Hardware7253/GP1247AI/Case/PCB_Assembly.step

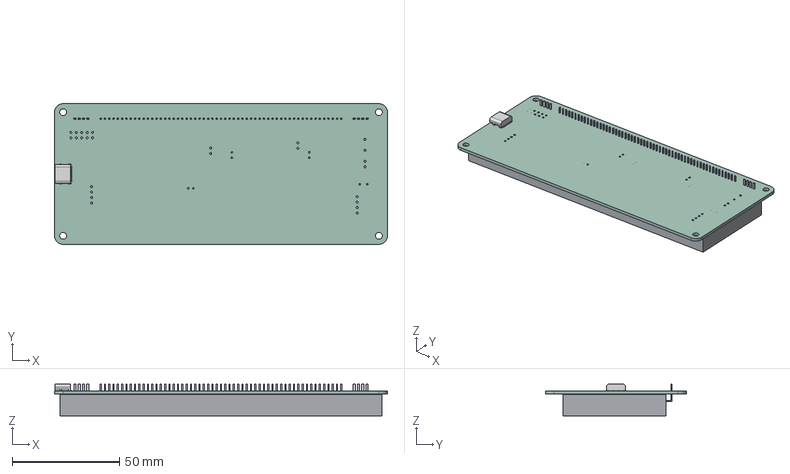
[picture p1: CAD file, 2026-02-13]
Case/PCB_Assembly.step
155.0 x 65.5 x 14.8 mm
HRO TYPE-C-31-M-12
Pin x 57
Filament Pin x 8
GP1247AI_PCB
