Hardware7253/GP1247AI/CAD/Case.step

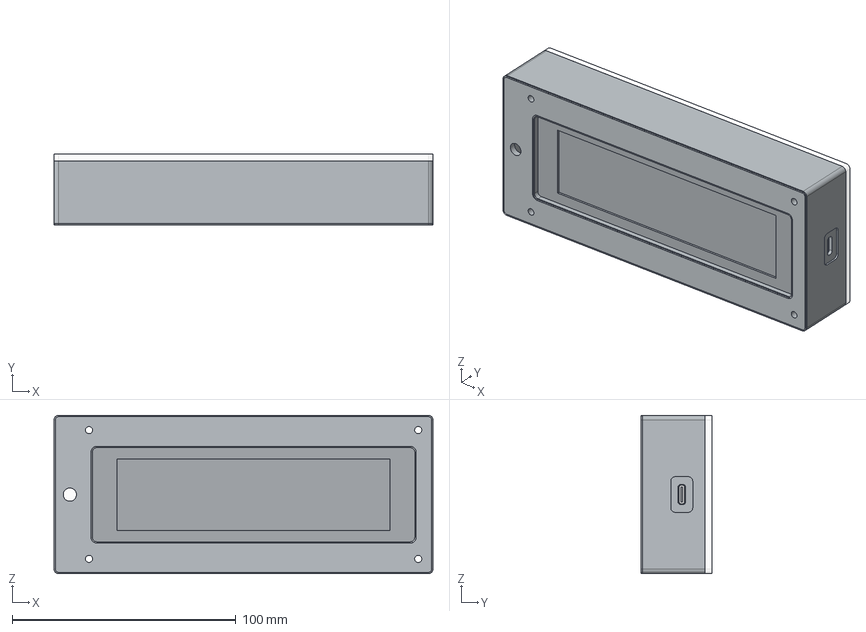
[picture p2: CAD file, 2026-02-13]
CAD/Case.step
169.3 x 31.5 x 70.7 mm
PCB South Spacer x 2
Case
GP1247AI_PCB
PCB North Spacer x 2
PCB Rear Spacer x 4
Display Spacer
HRO TYPE-C-31-M-12
Open Case Front Panel
Back Cover
Pin x 57
Filament Pin x 8
