Hardware7253/GP1247AI/PCB/3D/GP1247AI.step

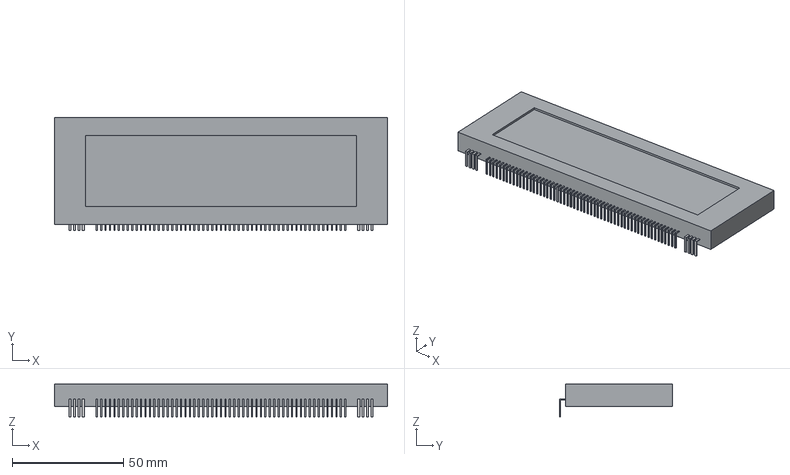
[picture p3: CAD file, 2026-02-13]
PCB/3D/GP1247AI.step
150.0 x 50.7 x 14.8 mm
Pin x 57
Filament Pin x 8
