Hardware7253/GP1247AI/PCB/3D/HRO  TYPE-C-31-M-12.step

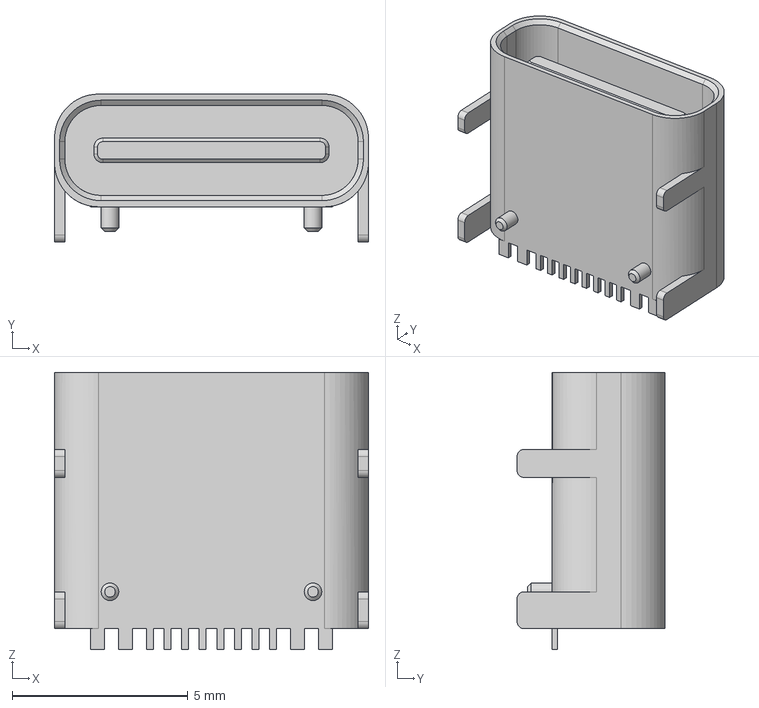
[picture p4: CAD file, 2026-02-09]
PCB/3D/HRO TYPE-C-31-M-12.step
8.94 x 4.21 x 7.90 mm
