Hardware7253/GP1247AI/PCB/3D/TC33X-1-103E.stp

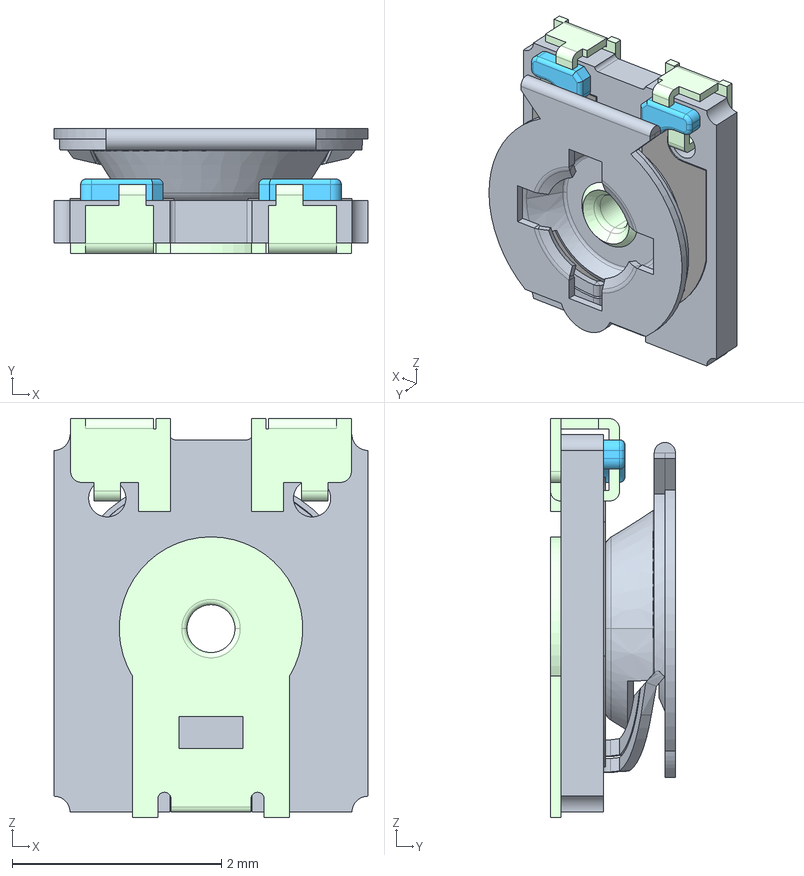
[picture p5: CAD file, 2025-11-30]
PCB/3D/TC33X-1-103E.stp
3.00 x 1.19 x 3.81 mm
TC33X_SUBSTRATE
TC33X_ELEMENT
TC33X-1_COLLECTOR
TC33X_CONTACT
TC33X_TERMINALS
TC33X_SOLDER
