Hardware7253/GP1247AI/PCB/3D/TestPoint_Keystone_5019_Minature.step

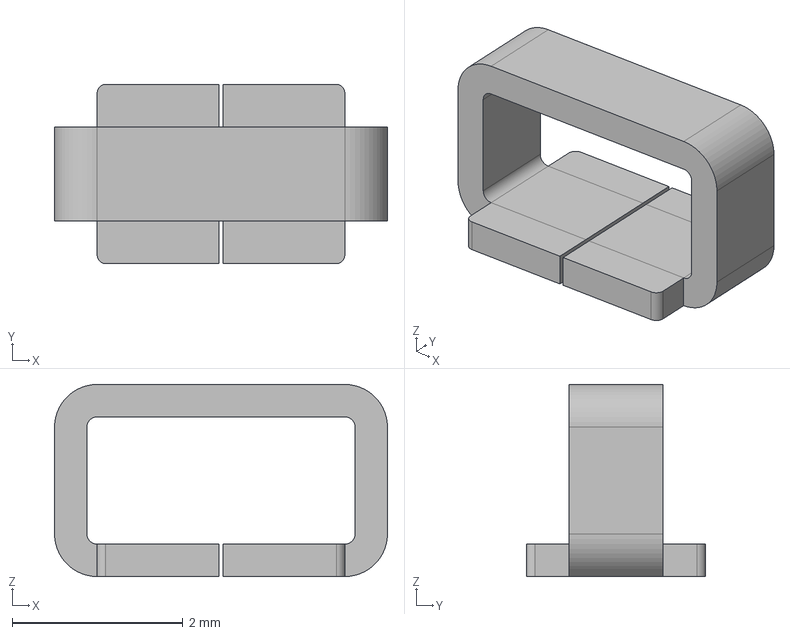
[picture p6: CAD file, 2025-11-30]
PCB/3D/TestPoint_Keystone_5019_Minature.step
3.90 x 2.10 x 2.25 mm
