Hardware7253/GP1247AI/PCB/3D/SCDS105R.step

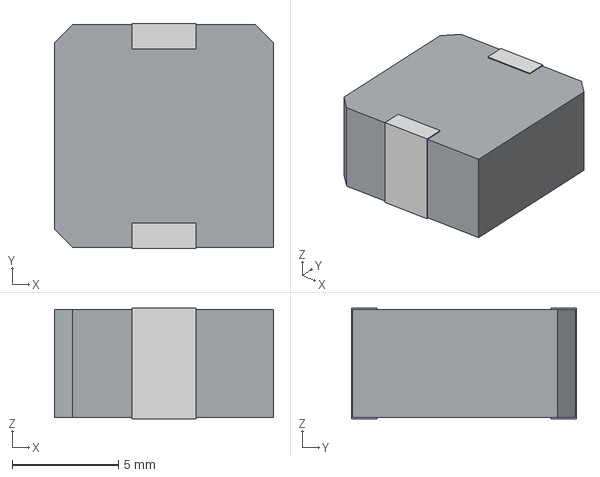
[picture p7: CAD file, 2025-11-30]
PCB/3D/SCDS105R.step
10.3 x 10.6 x 5.20 mm
