Hardware7253/GP1247AI/(list of files, cad)

Other CAD files:
Case/Case.step
