Hardware7253/GP1247AI/Case/manufacture/front_panel.pdf

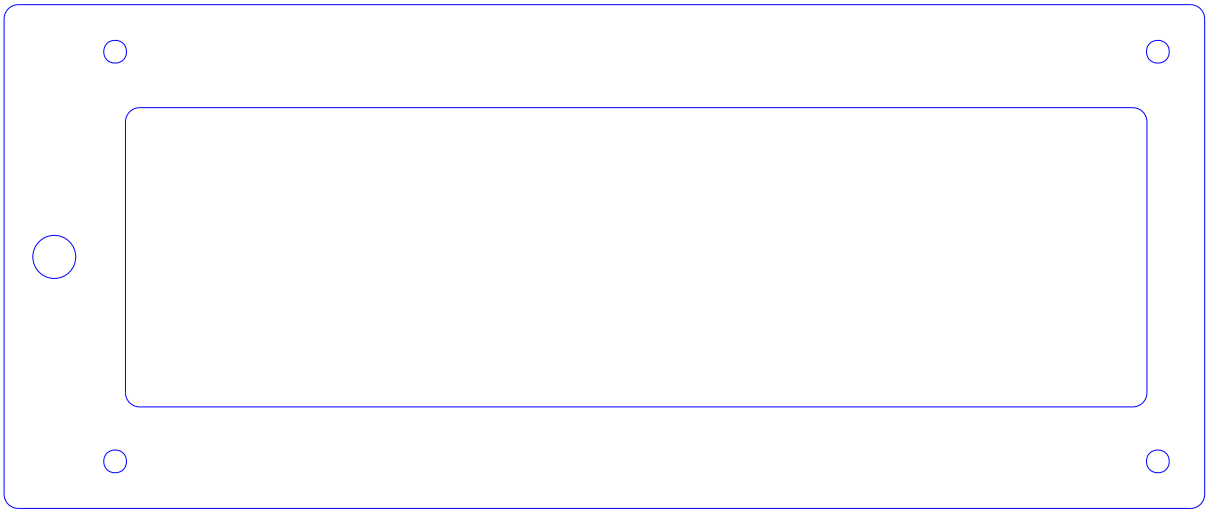
[picture p8: figure]
