Hardware7253/GP1247AI/Case/manufacture/back_panel.pdf

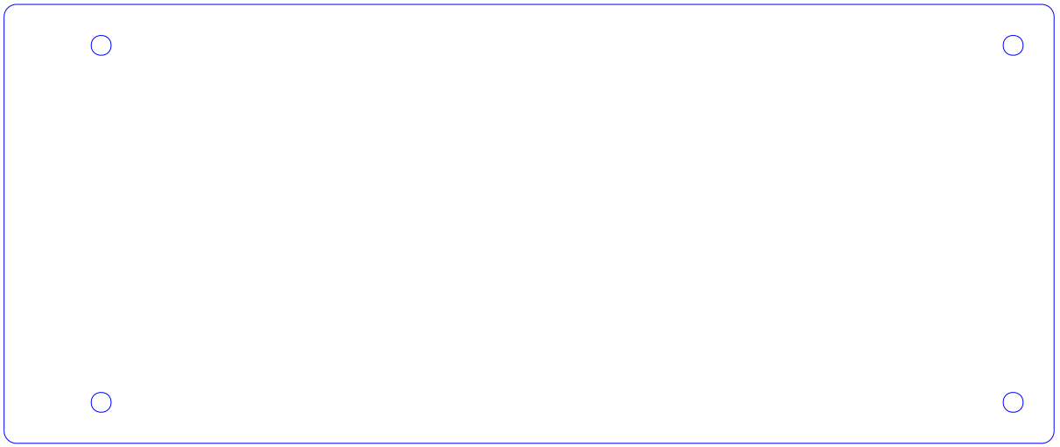
[picture p9: figure]
