Hardware7253/GP1247AI/PCB/GP1247AI.kicad_pcb

## KiCad design PCB/GP1247AI.kicad_pcb (2026-06-22)

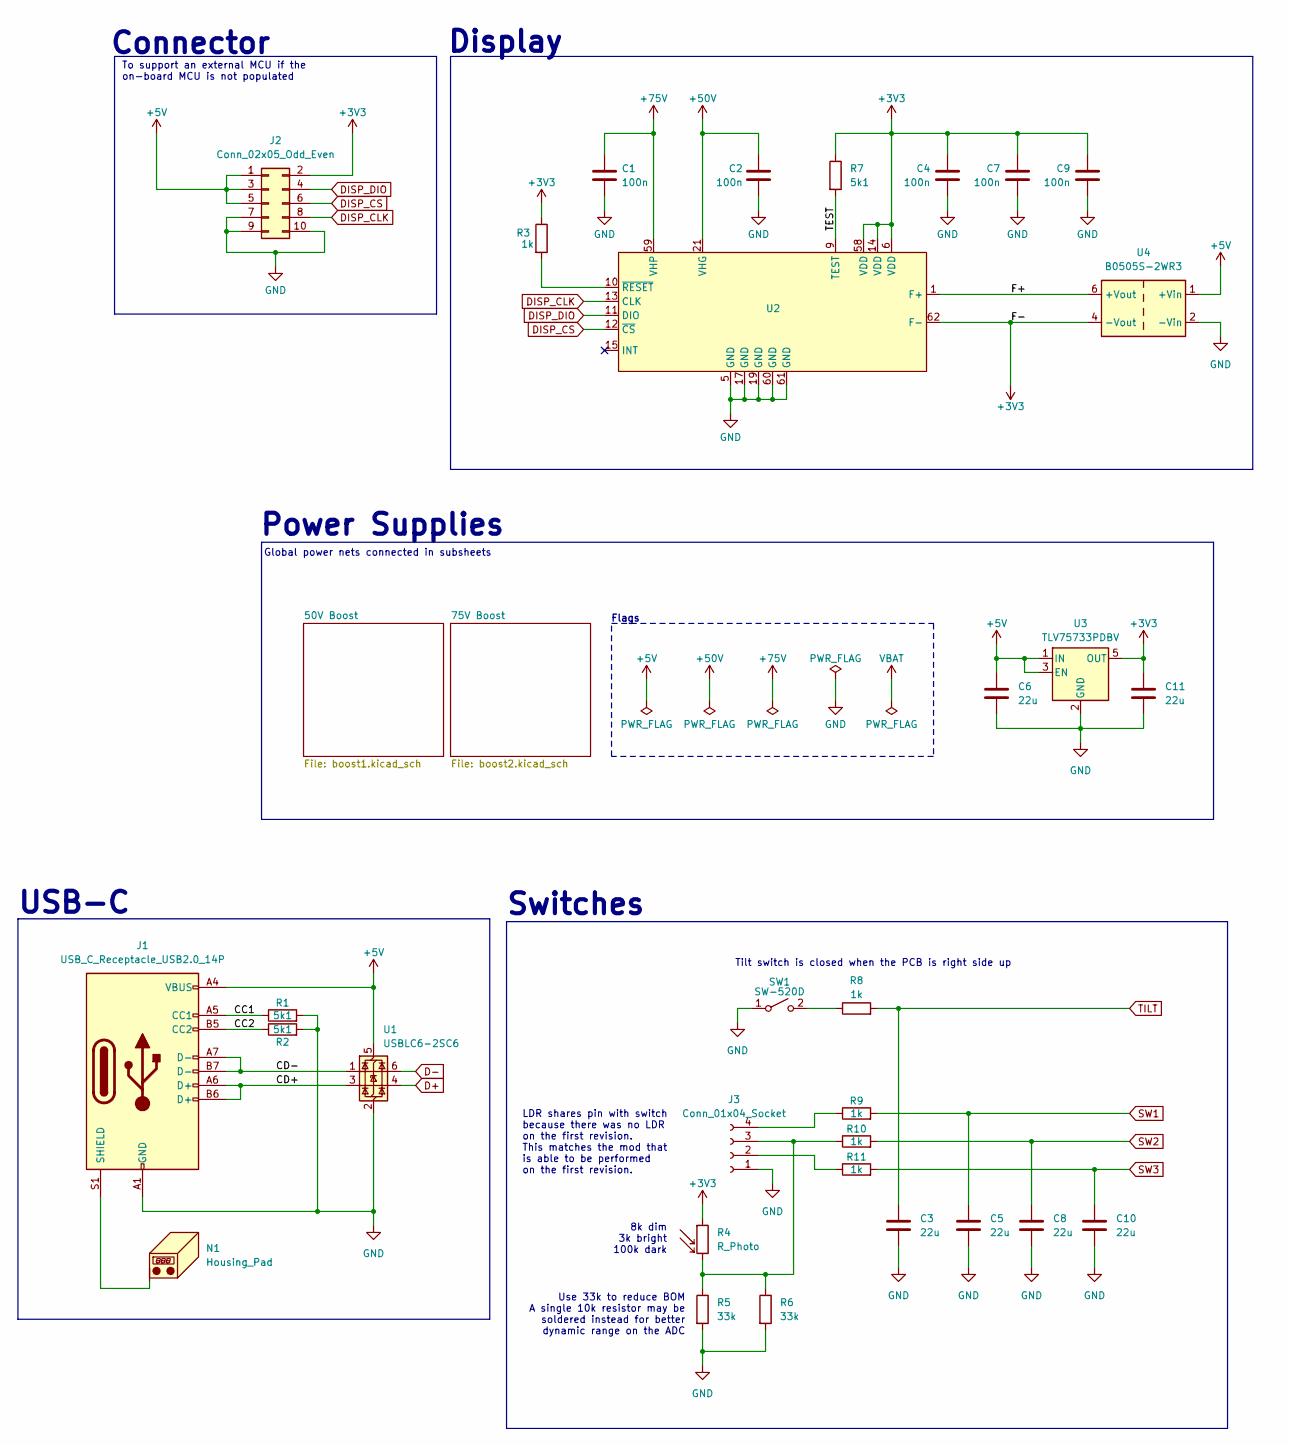
[picture p10: schematic GP1247AI.kicad_sch, GP1247AI Power Supply Board, part in row 1, column 1]

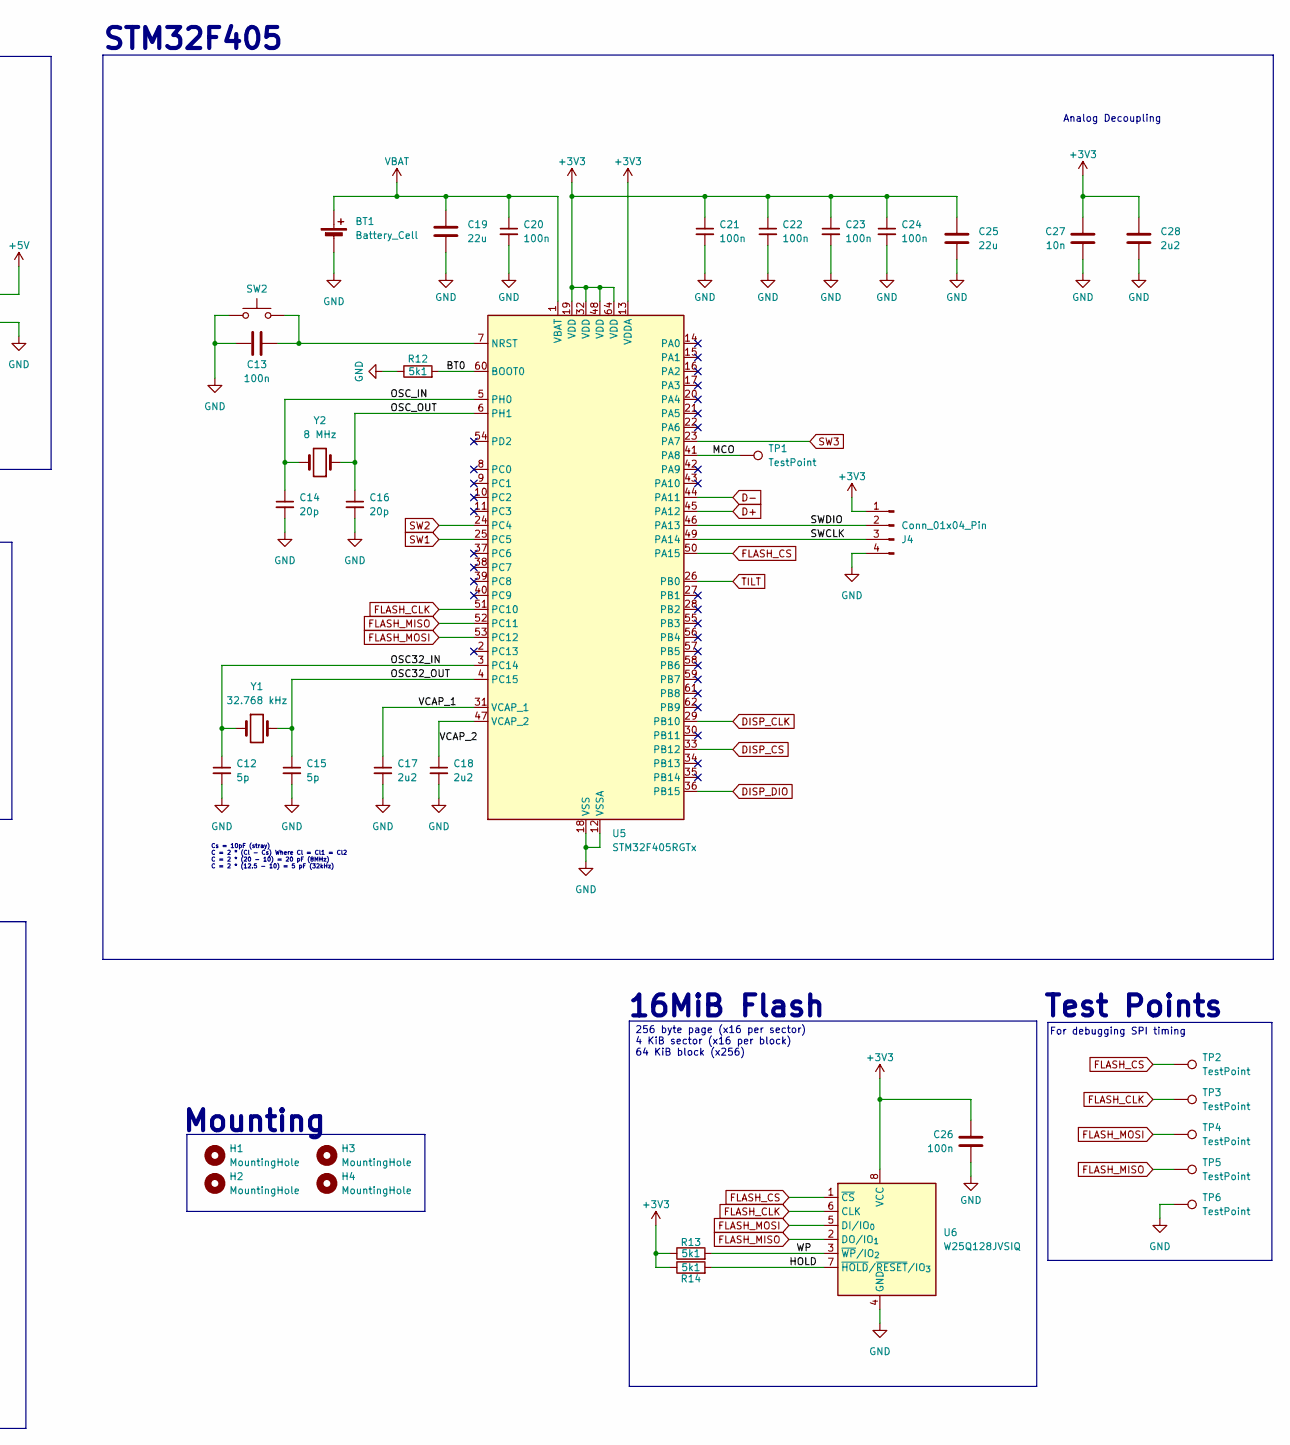
[picture p11: schematic GP1247AI.kicad_sch, GP1247AI Power Supply Board, part in row 1, column 2]

Parts:
BT1: Battery_Cell; QIJEY CR2032-BS-6-1; LCSC PART # C70377
C1, C2, C4, C7, C9, C13, C20, C21, C22, C23, C24, C26: 100n; C_0603_1608Metric; LCSC PART # C15725
C3, C5, C6, C8, C10, C11, C19, C25: 22u; C_0603_1608Metric; LCSC PART # C7432770
C12, C15: 5p; C_0603_1608Metric; LCSC PART # C327203
C14, C16: 20p; C_0603_1608Metric; LCSC PART # C326779
C17, C18, C28: 2u2; C_0603_1608Metric; LCSC PART # C23630
C27: 10n; C_0603_1608Metric; LCSC PART # C15725
H1, H2, H3, H4: MountingHole; MountingHole_3.2mm_M3
J1: USB_C_Receptacle_USB2.0_14P; USB_TYPE-C-31-M-12; LCSC PART # C165948
J2: Conn_02x05_Odd_Even; IDC-Header_2x05_P2.54mm_Vertical
J3: Conn_01x04_Socket; PinSocket_1x04_P2.54mm_Horizontal; LCSC PART # C2897386
J4: Conn_01x04_Pin; PinHeader_1x04_P2.54mm_Vertical
N1: Housing_Pad; TestPoint_Pad_2.0x2.0mm
R1, R2, R7, R12, R13, R14: 5k1; R_0603_1608Metric; LCSC PART # C23186
R3, R8, R9, R10, R11: 1k; R_0603_1608Metric; LCSC PART # C2907002
R4: R_Photo; R_LDR_5.1x4.3mm_P3.4mm_Vertical; LCSC PART # C125626
R5, R6: 33k; R_0603_1608Metric; LCSC PART # C2907028
SW1: SW-520D; LCSC PART # C2905288
SW2: SW_Push; Korean Hroparts Elec K2-1107ST-A4DW-06; LCSC PART # C118141
TP1: TestPoint; TestPoint_Pad_D1.5mm
TP2, TP3, TP4, TP5, TP6: TestPoint; TestPoint_Keystone_5019_Miniature; LCSC PART # C5199800
U1: USBLC6-2SC6; SOT-23-6; LCSC PART # C7519
U2: GP1247AI
U3: TLV75733PDBV; SOT-23-5; LCSC PART # C485517
U4: B0505S-2WR3; LCSC PART # C7465195
U5: STM32F405RGTx; LQFP-64_10x10mm_P0.5mm; LCSC PART # C15742
U6: W25Q128JVSIQ; SOIC-8_5.3x5.3mm_P1.27mm; LCSC PART # C2613930
Y1: 32.768 kHz; SMD3215-2P; LCSC PART # C42438016
Y2: 8 MHz; Crystal_SMD_5032-2Pin_5.0x3.2mm; LCSC PART # C46613796

Connections:
+3V3: C4.1, C7.1, C9.1, C11.1, C21.1, C22.1, C23.1, C24.1, C25.1, C26.1, C27.1, C28.1, J2.2, J4.1, R3.1, R4.1, R7.1, R13.1, R14.1, U2.6 (VDD), U2.14 (VDD), U2.58 (VDD), U2.62 (F-), U2.63 (F-), U2.64 (F-), U2.65 (F-), U3.5 (OUT), U4.4 (-Vout), U5.13 (VDDA), U5.19 (VDD), U5.32 (VDD), U5.48 (VDD), U5.64 (VDD), U6.8 (VCC)
+5V: C6.1, J1.A4 (VBUS), J1.A9 (VBUS), J1.B4 (VBUS), J1.B9 (VBUS), J2.1, J2.3, J2.5, U1.5 (VBUS), U3.1 (IN), U3.3 (EN), U4.1 (+Vin); also elsewhere on the board
+50V: C2.1, U2.21 (VHG); also elsewhere on the board
+75V: C1.1, U2.59 (VHP); also elsewhere on the board
/BT0: R12.2, U5.60 (BOOT0)
/CC1: J1.A5 (CC1), R1.1
/CC2: J1.B5 (CC2), R2.1
/CD+: J1.A6 (D+), J1.B6 (D+), U1.3 (I/O2)
/CD-: J1.A7 (D-), J1.B7 (D-), U1.1 (I/O1)
/F+: U2.1 (F+), U2.2 (F+), U2.3 (F+), U2.4 (F+), U4.6 (+Vout)
/HOLD: R14.2, U6.7 (~HOLD/~RESET/IO_{3})
/MCO: TP1.1 (1_1), U5.41 (PA8)
/OSC32_IN: C12.1, U5.3 (PC14), Y1.1
/OSC32_OUT: C15.1, U5.4 (PC15), Y1.2
/OSC_IN: C14.1, U5.5 (PH0), Y2.2
/OSC_OUT: C16.1, U5.6 (PH1), Y2.1
/SWCLK: J4.3, U5.49 (PA14)
/SWDIO: J4.2, U5.46 (PA13)
/TEST: R7.2, U2.9 (TEST)
/VCAP_1: C17.1, U5.31 (VCAP_1)
/VCAP_2: C18.1, U5.47 (VCAP_2)
/WP: R13.2, U6.3 (~WP/IO_{2})
D+: U1.4 (I/O2), U5.45 (PA12)
D-: U1.6 (I/O1), U5.44 (PA11)
DISP_CLK: J2.8, U2.13 (CLK), U5.29 (PB10)
DISP_CS: J2.6, U2.12 (~CS), U5.33 (PB12)
DISP_DIO: J2.4, U2.11 (DIO), U5.36 (PB15)
FLASH_CLK: TP3.1 (1_1), U5.51 (PC10), U6.6 (CLK)
FLASH_CS: TP2.1 (1_1), U5.50 (PA15), U6.1 (~CS)
FLASH_MISO: TP5.1 (1_1), U5.52 (PC11), U6.2 (DO/IO_{1})
FLASH_MOSI: TP4.1 (1_1), U5.53 (PC12), U6.5 (DI/IO_{0})
GND: BT1.2 (-), C1.2, C2.2, C3.2, C4.2, C5.2, C6.2, C7.2, C8.2, C9.2, C10.2, C11.2, C12.2, C13.1, C14.2, C15.2, C16.2, C17.2, C18.2, C19.2, C20.2, C21.2, C22.2, C23.2, C24.2, C25.2, C26.2, C27.2, C28.2, J1.A1 (GND), J1.A12 (GND), J1.B1 (GND), J1.B12 (GND), J2.7, J2.9, J2.10, J3.1, J4.4, R1.2, R2.2, R5.2, R6.2, R12.1, SW1.1 (A), SW2.1, TP6.1 (1_1), U1.2 (GND), U2.5 (GND), U2.17 (GND), U2.19 (GND), U2.60 (GND), U2.61 (GND), U3.2 (GND), U4.2 (-Vin), U5.12 (VSSA), U5.18 (VSS), U5.63 (VSS), U6.4 (GND); also elsewhere on the board
unnamed: J1.S1 (SHIELD), N1.1 (PAD_1)
unnamed: J3.2, R11.1
unnamed: J3.3, R4.2, R5.1, R6.1, R10.1
unnamed: J3.4, R9.1
unnamed: R8.1, SW1.2 (B)
unnamed: R3.2, U2.10 (~RESET)
unnamed: C13.2, SW2.2, U5.7 (NRST)
SW1: C5.1, R9.2, U5.25 (PC5)
SW2: C8.1, R10.2, U5.24 (PC4)
SW3: C10.1, R11.2, U5.23 (PA7)
TILT: C3.1, R8.2, U5.26 (PB0)
VBAT: BT1.1 (+), C19.1, C20.1, U5.1 (VBAT)

Notes on the sheet:
Cs = 10pF (stray) C = 2 * (Cl - Cs) Where Cl = Cl1 = Cl2 C = 2 * (20 - 10) = 20 pF (8MHz) C = 2 * (12.5 - 10) = 5 pF (32kHz)
Mounting
LDR shares pin with switch because there was no LDR on the first revision. This matches the mod that is able to be performed on the first revision.
Display
Tilt switch is closed when the PCB is right side up
USB-C
For debugging SPI timing
8k dim 3k bright 100k dark
256 byte page (x16 per sector) 4 KiB sector (x16 per block) 64 KiB block (x256)
Switches
Global power nets connected in subsheets
To support an external MCU if the on-board MCU is not populated
Power Supplies
STM32F405
Connector
Use 33k to reduce BOM A single 10k resistor may be soldered instead for better dynamic range on the ADC
Flags
Test Points
16MiB Flash
Analog Decoupling

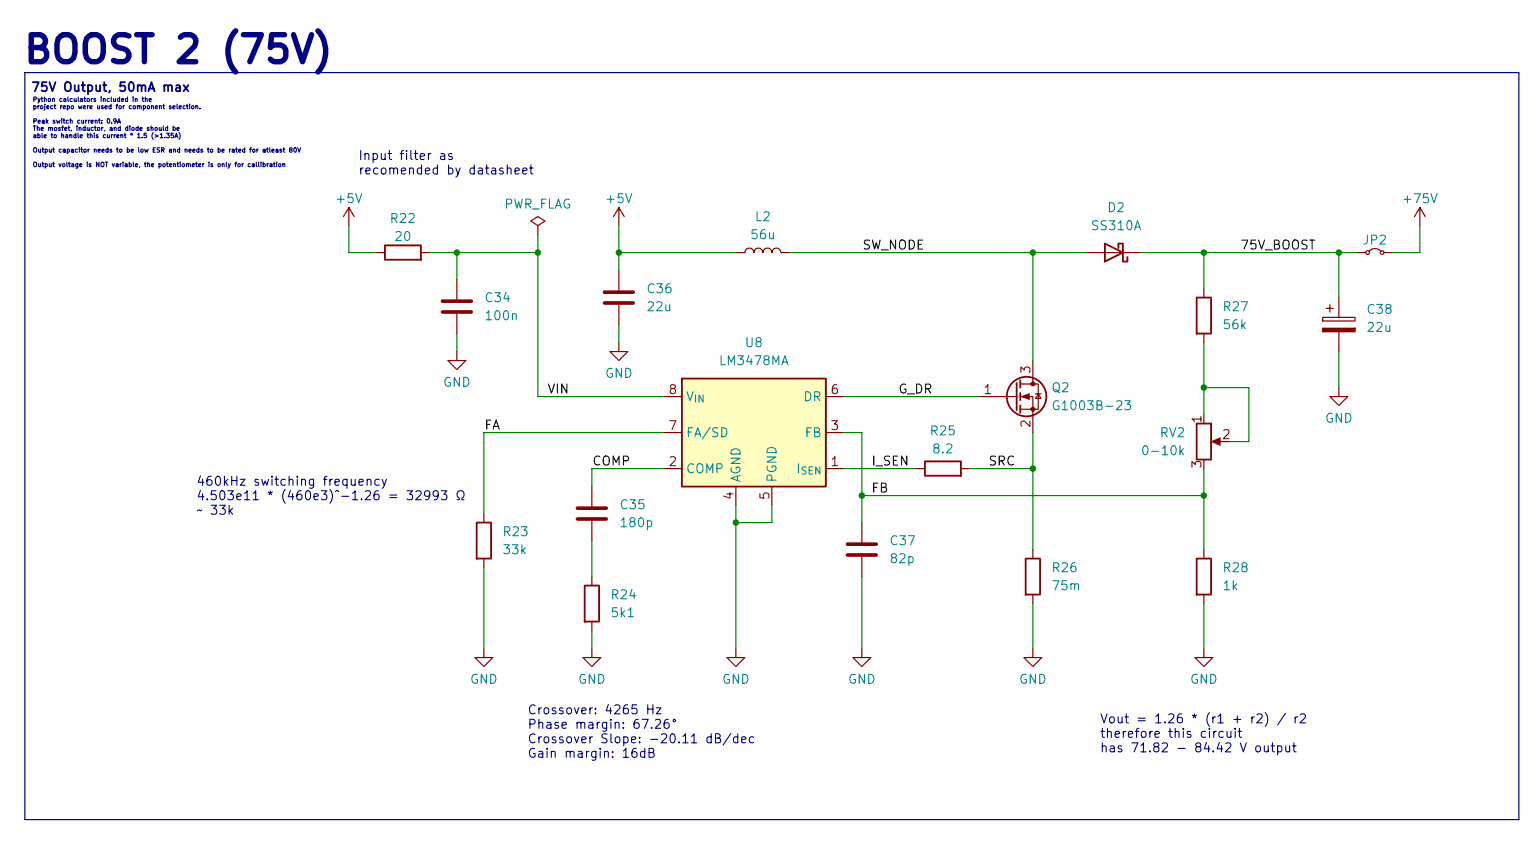
[picture p12: schematic boost2.kicad_sch, 75V Boost Converter]

Parts:
C34: 100n; C_0603_1608Metric; LCSC PART # C15725
C35: 180p; C_0603_1608Metric; LCSC PART # C2170987
C36: 22u; C_0603_1608Metric; LCSC PART # C7432770
C37: 82p; C_0603_1608Metric; LCSC PART # C1864236
C38: 22u; CP_Radial_D6.3mm_P2.50mm; LCSC PART # C44606504
D2: SS310A; D_SMA; LCSC PART # C48996628
JP2: Jumper_2_Small_Bridged; PinHeader_1x02_P2.54mm_Vertical
L2: 56u; Chilisin SCDS105R; LCSC PART # C329728
Q2: G1003B-23; SOT-23-3; LCSC PART # C22362809
R22: 20; R_0603_1608Metric; LCSC PART # C2907012
R23: 33k; R_0603_1608Metric; LCSC PART # C2907028
R24: 5k1; R_0603_1608Metric; LCSC PART # C23186
R25: 8.2; R_0603_1608Metric; LCSC PART # C861594
R26: 75m; R_1206_3216Metric; LCSC PART # C2904225
R27: 56k; R_0603_1608Metric; LCSC PART # C2907053
R28: 1k; R_0603_1608Metric; LCSC PART # C2907002
RV2: 0-10k; Potentiometer_Bourns_TC33X_Vertical; LCSC PART # C719176
U8: LM3478MA; SOIC-8_3.9x4.9mm_P1.27mm; LCSC PART # C115907

Connections:
+5V: C36.1, L2.1, R22.1; also elsewhere on the board
+75V: JP2.2 (B); also elsewhere on the board
/75V Boost/75V_BOOST: C38.1, D2.1 (K), JP2.1 (A), R27.1
/75V Boost/COMP: C35.1, U8.2 (COMP)
/75V Boost/FA: R23.1, U8.7 (FA/SD)
/75V Boost/FB: C37.1, R28.1, RV2.3, U8.3 (FB)
/75V Boost/G_DR: Q2.1 (G), U8.6 (DR)
/75V Boost/I_SEN: R25.1, U8.1 (I_{SEN})
/75V Boost/SRC: Q2.2 (S), R25.2, R26.1
/75V Boost/SW_NODE: D2.2 (A), L2.2, Q2.3 (D)
/75V Boost/VIN: C34.1, R22.2, U8.8 (V_{IN})
GND: C34.2, C36.2, C37.2, C38.2, R23.2, R24.2, R26.2, R28.2, U8.4 (AGND), U8.5 (PGND); also elsewhere on the board
unnamed: C35.2, R24.1
unnamed: R27.2, RV2.1, RV2.2

Notes on the sheet:
75V Output, 50mA max
460kHz switching frequency 4.503e11 * (460e3)^-1.26 = 32993 Ω ~ 33k
BOOST 2 (75V)
Python calculators included in the project repo were used for component selection. Peak switch current: 0.9A The mosfet, inductor, and diode should be able to handle this current * 1.5 (>1.35A) Output capacitor needs to be low ESR and needs to be rated for atleast 80V Output voltage is NOT variable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
Input filter as recomended by datasheet
Vout = 1.26 * (r1 + r2) / r2 therefore this circuit has 71.82 - 84.42 V output
Crossover: 4265 Hz Phase margin: 67.26° Crossover Slope: -20.11 dB/dec Gain margin: 16dB

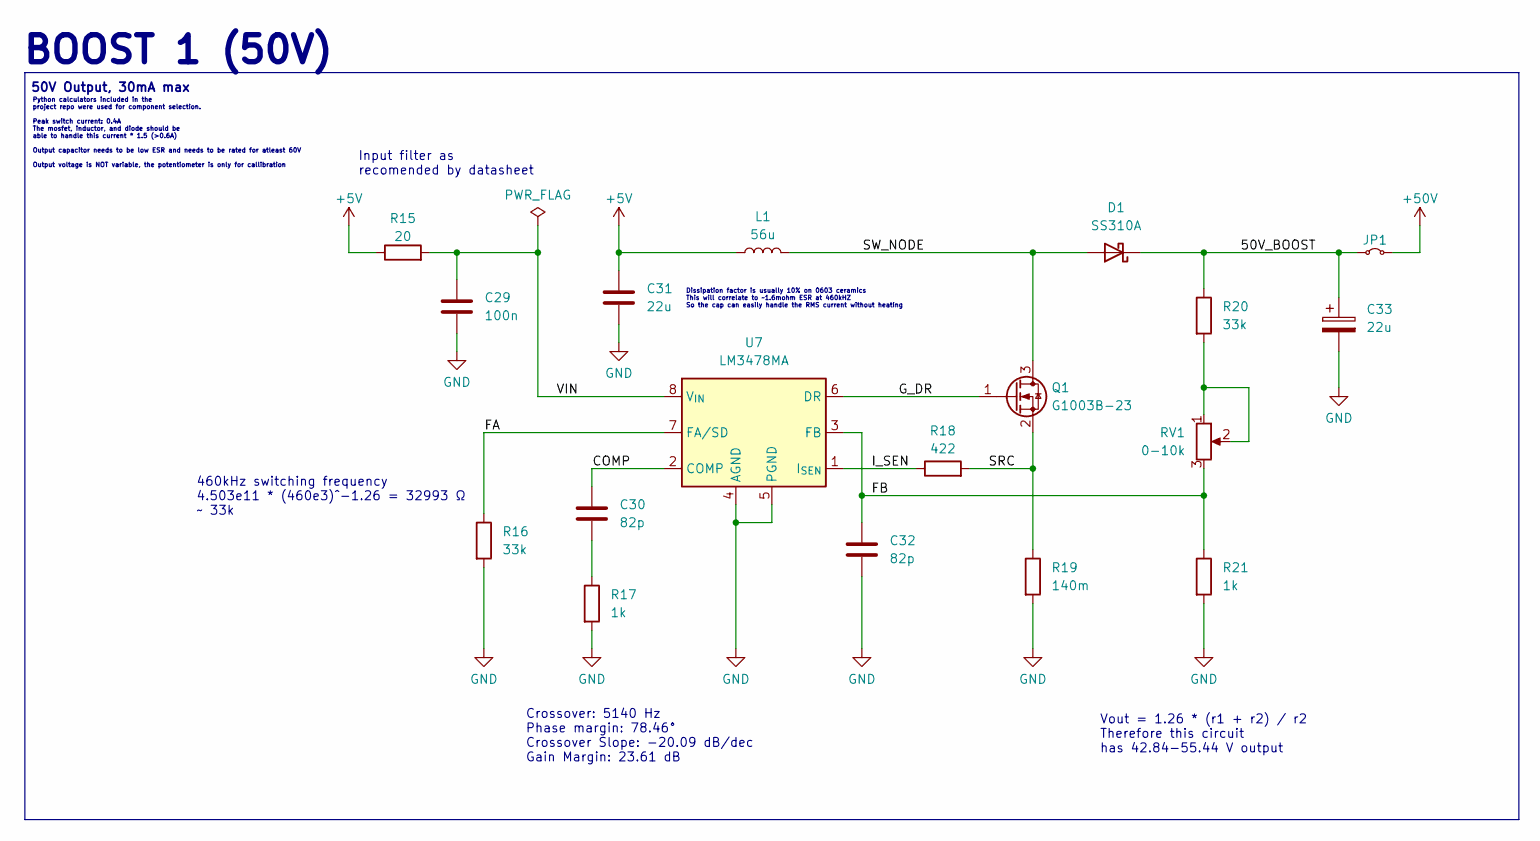
[picture p13: schematic boost1.kicad_sch, 50V Boost Converter]

Parts:
C29: 100n; C_0603_1608Metric; LCSC PART # C15725
C30, C32: 82p; C_0603_1608Metric; LCSC PART # C1864236
C31: 22u; C_0603_1608Metric; LCSC PART # C7432770
C33: 22u; CP_Radial_D6.3mm_P2.50mm; LCSC PART # C44606504
D1: SS310A; D_SMA; LCSC PART # C48996628
JP1: Jumper_2_Small_Bridged; PinHeader_1x02_P2.54mm_Vertical
L1: 56u; Chilisin SCDS105R; LCSC PART # C329728
Q1: G1003B-23; SOT-23-3; LCSC PART # C22362809
R15: 20; R_0603_1608Metric; LCSC PART # C2907012
R16, R20: 33k; R_0603_1608Metric; LCSC PART # C2907028
R17, R21: 1k; R_0603_1608Metric; LCSC PART # C2907002
R18: 422; R_0603_1608Metric; LCSC PART # C5204003
R19: 140m; R_1206_3216Metric; LCSC PART # C37935
RV1: 0-10k; Potentiometer_Bourns_TC33X_Vertical; LCSC PART # C719176
U7: LM3478MA; SOIC-8_3.9x4.9mm_P1.27mm; LCSC PART # C115907

Connections:
+5V: C31.1, L1.1, R15.1; also elsewhere on the board
+50V: JP1.2 (B); also elsewhere on the board
/50V Boost/50V_BOOST: C33.1, D1.1 (K), JP1.1 (A), R20.1
/50V Boost/COMP: C30.1, U7.2 (COMP)
/50V Boost/FA: R16.1, U7.7 (FA/SD)
/50V Boost/FB: C32.1, R21.1, RV1.3, U7.3 (FB)
/50V Boost/G_DR: Q1.1 (G), U7.6 (DR)
/50V Boost/I_SEN: R18.1, U7.1 (I_{SEN})
/50V Boost/SRC: Q1.2 (S), R18.2, R19.1
/50V Boost/SW_NODE: D1.2 (A), L1.2, Q1.3 (D)
/50V Boost/VIN: C29.1, R15.2, U7.8 (V_{IN})
GND: C29.2, C31.2, C32.2, C33.2, R16.2, R17.2, R19.2, R21.2, U7.4 (AGND), U7.5 (PGND); also elsewhere on the board
unnamed: C30.2, R17.1
unnamed: R20.2, RV1.1, RV1.2

Notes on the sheet:
BOOST 1 (50V)
50V Output, 30mA max
Crossover: 5140 Hz Phase margin: 78.46° Crossover Slope: -20.09 dB/dec Gain Margin: 23.61 dB
Input filter as recomended by datasheet
Vout = 1.26 * (r1 + r2) / r2 Therefore this circuit has 42.84-55.44 V output
460kHz switching frequency 4.503e11 * (460e3)^-1.26 = 32993 Ω ~ 33k
Python calculators included in the project repo were used for component selection. Peak switch current: 0.4A The mosfet, inductor, and diode should be able to handle this current * 1.5 (>0.6A) Output capacitor needs to be low ESR and needs to be rated for atleast 60V Output voltage is NOT variable,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
Dissipation factor is usually 10% on 0603 ceramics This will correlate to ~1.6mohm ESR at 460kHZ So the cap can easily handle the RMS current without heating

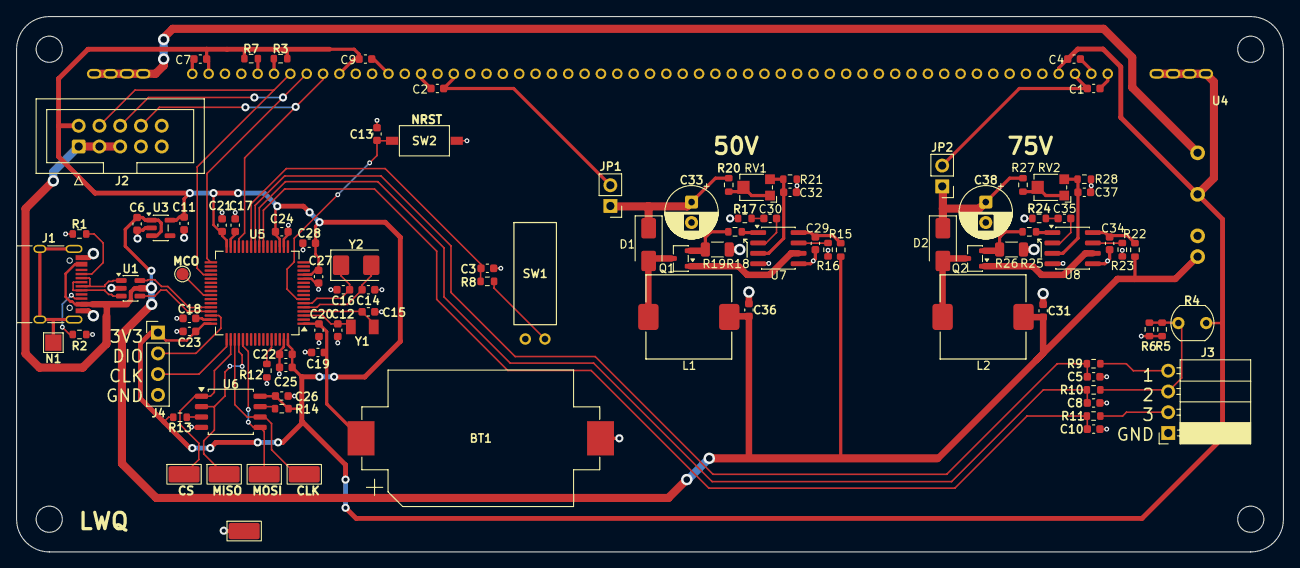
[picture p14: board GP1247AI.kicad_pcb from above]

Board: 2 copper layers, 155.0 x 65.5 mm, 104 parts (1 on the bottom side), 66 nets.
