Hardware7253/GP1247AI/Code/main_csrc/system/system.h

#pragma once

#include "stm32f4xx_hal_def.h"

// General prupose error and ok to be used with the error handler functions
#define GP_ERROR    HAL_ERROR
#define GP_OK       HAL_OK

void init_clocks(void);
void error_handler(HAL_StatusTypeDef status);
void error_handler_msg(HAL_StatusTypeDef status, volatile char* msg);
uint32_t get_tick_frequency(void);
