Hardware7253/GP1247AI/(commit log)

2026-02-09 Added onboard MCU
    [GP1247AI.kicad_sch, GP1247AI_BOM.csv, HRO TYPE-C-31-M-12.step, TestPoint_Keystone_5019_Minature.step, boost1.kicad_sch, boost2.kicad_sch]
2026-02-13 Added LDR to PCB
    Forgot the LDR in the first revision. It was added to the PCB in such a
    way to be pin compatible with an LDR mod on the first revision.
    Also re-organised project into PCB, CAD, and Code directories
    [Case.step, GP1247AI.kicad_sch, GP1247AI.step, GP1247AI_BOM.csv, HRO TYPE-C-31-M-12.step, PCB_Assembly.step, SCDS105R.step, TC33X-1-103E.stp]
2026-02-19 Updated manufacturing outputs for case files
    [Case.step, PCB_Assembly.step]
2026-02-26 Added code
    Code directory now contains embedded c code for the onboard
    microcontroller, and PC side python CLI programs for uploading
    animations and setting RTC time on the device.
    This is one commit but the code has been in progress for 1.5 months.
    [GP1247AI.kicad_pcb]
2026-03-06 Add 12 hour mode and night mode
    Night mode sets the display brightness low enough to not illuminate a
    pitch black room
2026-05-15 Fixed floating boot0
    [GP1247AI.kicad_pcb, GP1247AI.kicad_sch, boost1.kicad_sch, boost2.kicad_sch]
2026-05-15 Updated manufacturing outputs
    [GP1247AI.csv]
2026-05-16 Remove old BOM
    [GP1247AI_BOM.csv]
2026-06-22 Fixed swapped reference designators
    Fixed swapped reference designators on the silkscreen for: R15 & R16, R22 & R23, and C14 & C15
    [GP1247AI.kicad_pcb]
